hasauino/pusher_1290/renders/front.png

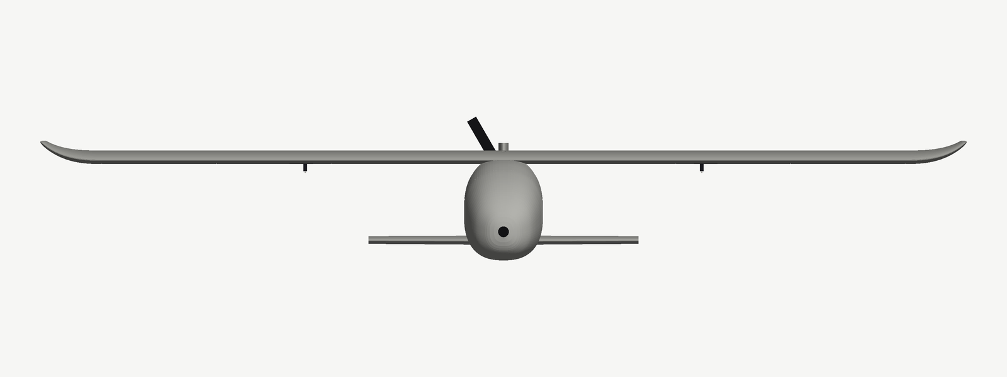
renders/front.png
