hasauino/pusher_1290/renders/internals.png

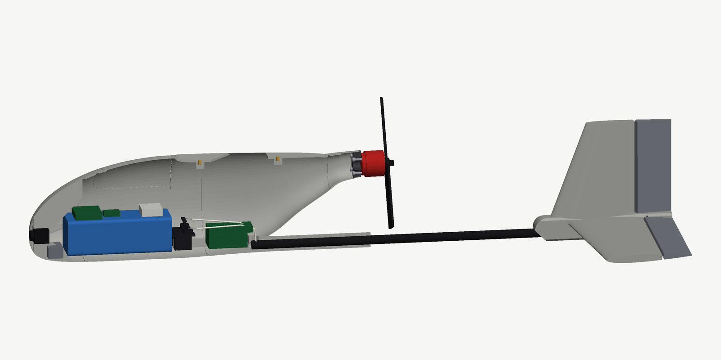
renders/internals.png
