hasauino/pusher_1290/renders/iso_rear.png

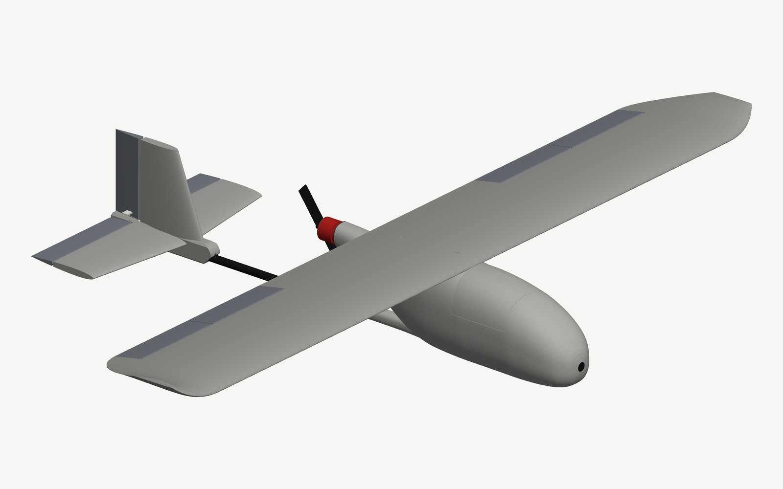
renders/iso_rear.png
