hasauino/pusher_1290/renders/side.png

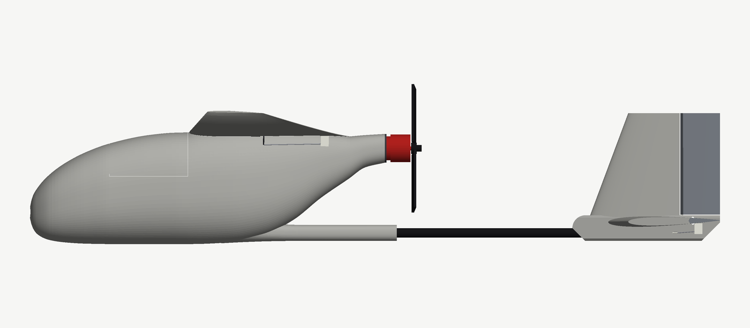
renders/side.png
