hasauino/pusher_1290/renders/top.png

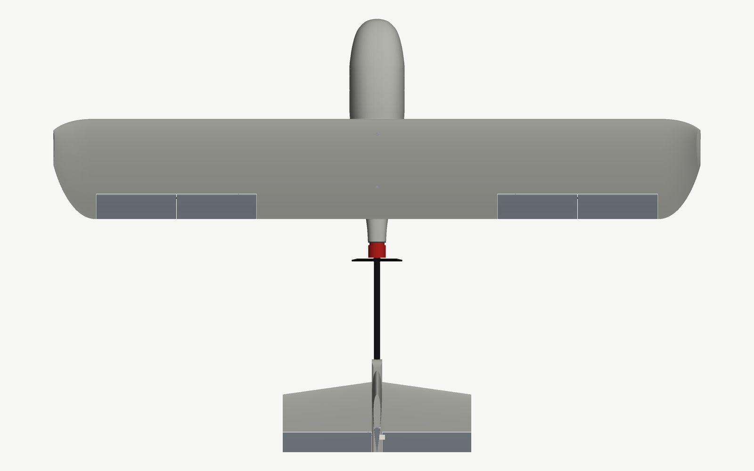
renders/top.png
