hasauino/pusher_1290/stl/PARTS.md

| File | Material | X x Y x Z on bed (mm) | Printed mass* (g) | Notes |
|---|---|---|---|---|
| 01_wing_center.stl | PLA | 142 x 142 x 160 | 52 | Bolts to the fuselage with 2x M3; carries both spars. |
| 02_wing_s1_R.stl | PLA | 142 x 142 x 160 | 50 | Plain panel. |
| 03_wing_s1_L.stl | PLA | 142 x 142 x 160 | 50 | Plain panel. |
| 04_wing_s2_R.stl | PLA | 110 x 109 x 160 | 58 | Aileron servo pocket (bottom). |
| 05_wing_s2_L.stl | PLA | 109 x 110 x 160 | 58 | Aileron servo pocket (bottom). |
| 06_wing_s3_R.stl | PLA | 110 x 109 x 160 | 43 | Outer aileron panel. |
| 07_wing_s3_L.stl | PLA | 109 x 110 x 160 | 43 | Outer aileron panel. |
| 08_wing_tip_R.stl | PLA | 143 x 144 x 85 | 26 | Upswept tip; print root down. |
| 09_wing_tip_L.stl | PLA | 144 x 143 x 85 | 26 | Upswept tip; print root down. |
| 10_aileron_inner_R.stl | PLA | 36 x 37 x 159 | 12 | Joined to the outer aileron by a 3 mm carbon rod. |
| 11_aileron_inner_L.stl | PLA | 37 x 36 x 159 | 12 | Joined to the outer aileron by a 3 mm carbon rod. |
| 12_aileron_outer_R.stl | PLA | 36 x 37 x 159 | 12 |  |
| 13_aileron_outer_L.stl | PLA | 37 x 36 x 159 | 12 |  |
| 14_fuse_1_nose.stl | PLA | 121 x 108 x 85 | 41 | Camera nose; slides over the front segment's sleeve (screw or tape it). |
| 15_fuse_2_front.stl | PLA | 136 x 136 x 175 | 98 | Battery bay; hatch on top. |
| 16_fuse_3_rear.stl | PLA | 131 x 131 x 175 | 109 | Wing saddle rear, boom socket start, motor cone start. |
| 17_fuse_4_tail_motor_cone.stl | PETG | 50 x 50 x 40 | 7 | Print in PETG/PLA: carries the motor. |
| 18_fuse_4_tail_boom_socket.stl | PLA | 20 x 21 x 45 | 13 | Boom tail of the socket; the boom aligns it. |
| 19_fuse_hatch.stl | PLA | 95 x 95 x 104 | 19 | Battery hatch: front tab hooks under the skin; tape or a magnet at the back. |
| 20_motor_mount.stl | PETG | 37 x 36 x 10 | 11 | Check the hole pattern against your motor before printing. |
| 21_tail_fin_hub.stl | PLA | 145 x 145 x 160 | 41 | Boom socket, fin, stab mounts, elevator + rudder servo pockets. |
| 22_tail_rudder.stl | PLA | 37 x 37 x 127 | 10 |  |
| 23_tail_stab_R.stl | PLA | 74 x 74 x 178 | 28 | Root face down. |
| 24_tail_stab_L.stl | PLA | 74 x 74 x 178 | 28 | Root face down. |
| 25_tail_elevator_R.stl | PLA | 29 x 29 x 177 | 10 | Halves joined by a 2 mm wire. |
| 26_tail_elevator_L.stl | PLA | 29 x 29 x 177 | 10 | Halves joined by a 2 mm wire. |

*Estimate in PLA (PETG where marked) with the README print settings: wing panels and fuselage shells are modelled at their true wall thickness; solid parts (tips, tail, ailerons) print with one wall and 5 % infill.
