hasauino/pusher_1290/renders/parts_sheet.png

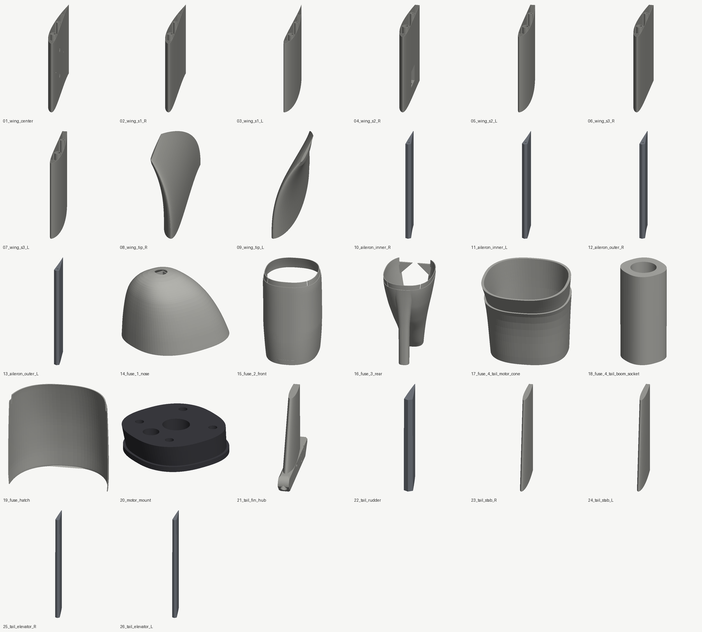
renders/parts_sheet.png
