hasauino/pusher_1290/assembly/pusher_1290_full.3mf

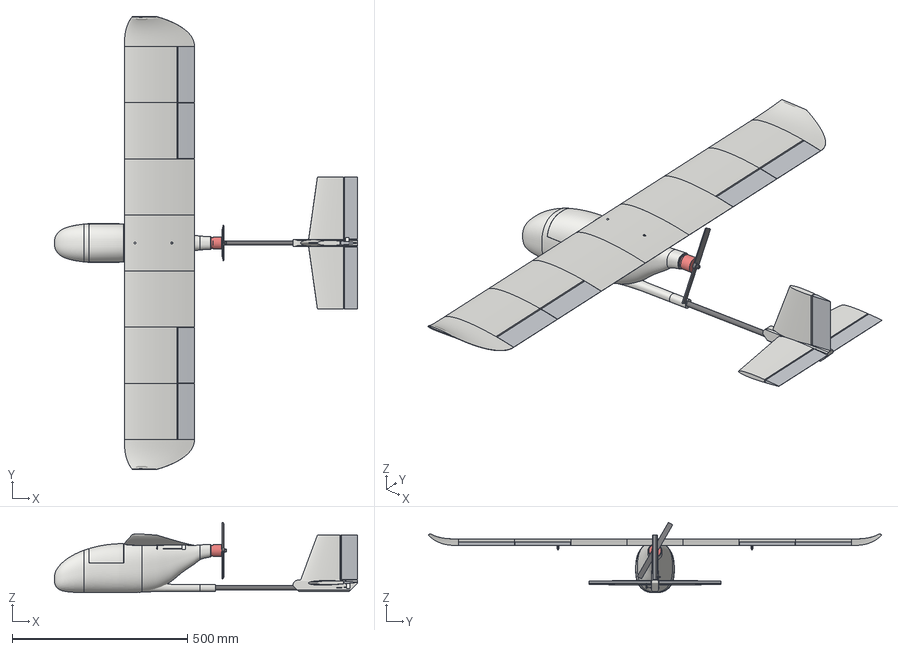
[picture p11: CAD file, 2026-10-11]
assembly/pusher_1290_full.3mf
864.7 x 1290.9 x 200.7 mm
wing_center
wing_s1_R
wing_s1_L
wing_s2_R
wing_s2_L
wing_s3_R
wing_s3_L
wing_tip_R
wing_tip_L
aileron_inner_R
aileron_inner_L
aileron_outer_R
aileron_outer_L
fuse_1_nose
fuse_2_front
fuse_3_rear
fuse_4_tail_motor_cone
fuse_4_tail_boom_socket
fuse_hatch
motor_mount
tail_fin_hub
tail_rudder
tail_stab_R
tail_stab_L
tail_elevator_R
tail_elevator_L
Main spar
Rear spar R
Rear spar L
Aileron joiner R
Aileron joiner L
Boom
Stab spar
Stab pin
Elevator joiner
Wing bolt front
Heat-set insert front
Wing bolt rear
Heat-set insert rear
Motor screw -9.5/-9.5
Motor screw -9.5/+9.5
Motor screw +9.5/-9.5
Motor screw +9.5/+9.5
Aileron servo R
Aileron servo L
Elevator servo
Rudder servo
Elevator Bowden cable
Elevator pushrod ends
Elevator horn
Rudder Bowden cable
Rudder pushrod ends
Rudder horn
Aileron horn R
Aileron pushrod R
Aileron horn L
Aileron pushrod L
Motor
Propeller
Battery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
