hasauino/pusher_1290/stl/16_fuse_3_rear.stl

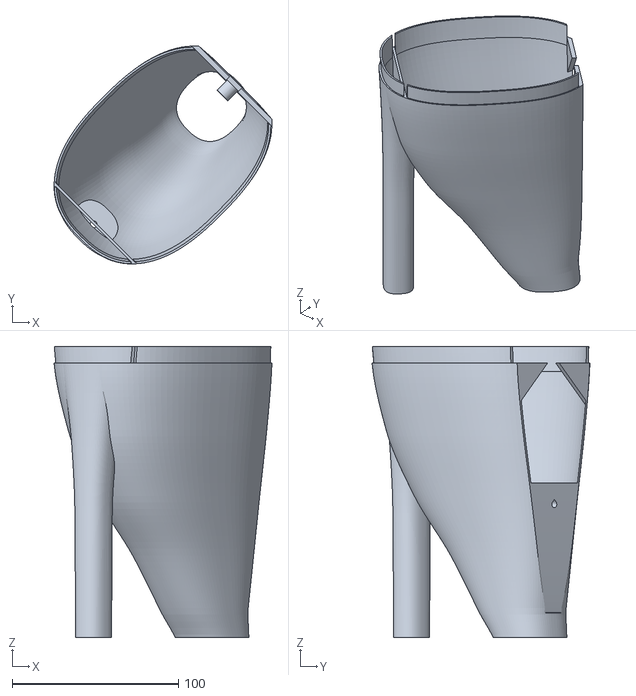
[picture p12: CAD file, 2026-10-11]
stl/16_fuse_3_rear.stl
131.0 x 131.0 x 175.0
