hasauino/pusher_1290/assembly/pusher_1290.stl

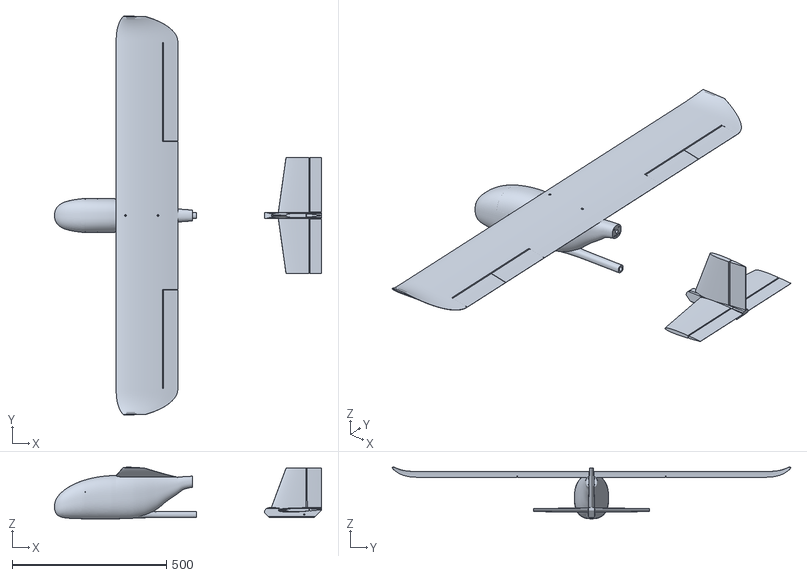
[picture p13: CAD file, 2026-10-11]
assembly/pusher_1290.stl
864.7 x 1290.9 x 167.1
