hasauino/pusher_1290/stl/21_tail_fin_hub.stl

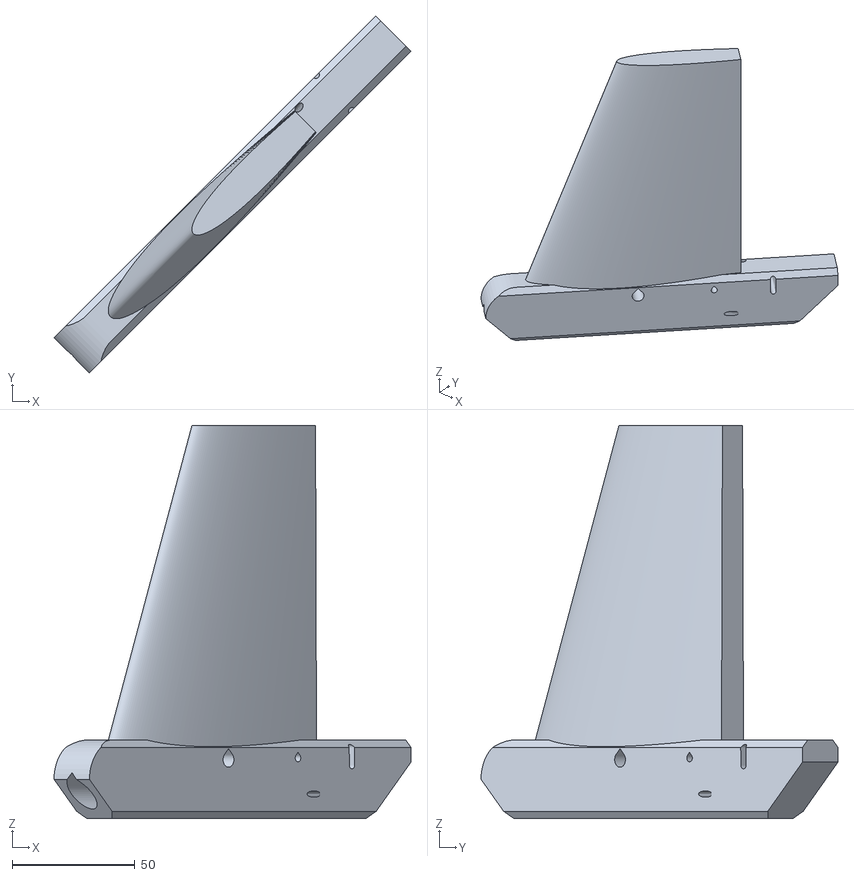
[picture p14: CAD file, 2026-10-11]
stl/21_tail_fin_hub.stl
145.2 x 145.2 x 160.0
