hasauino/pusher_1290/stl/07_wing_s3_L.stl

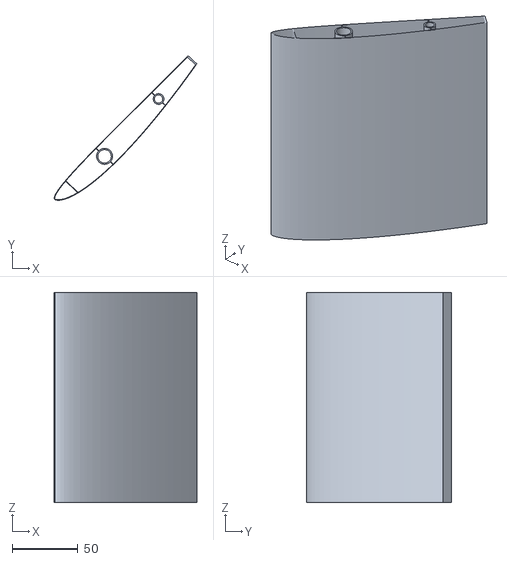
[picture p15: CAD file, 2026-10-11]
stl/07_wing_s3_L.stl
108.8 x 110.2 x 160.0
