hasauino/pusher_1290/stl/02_wing_s1_R.stl

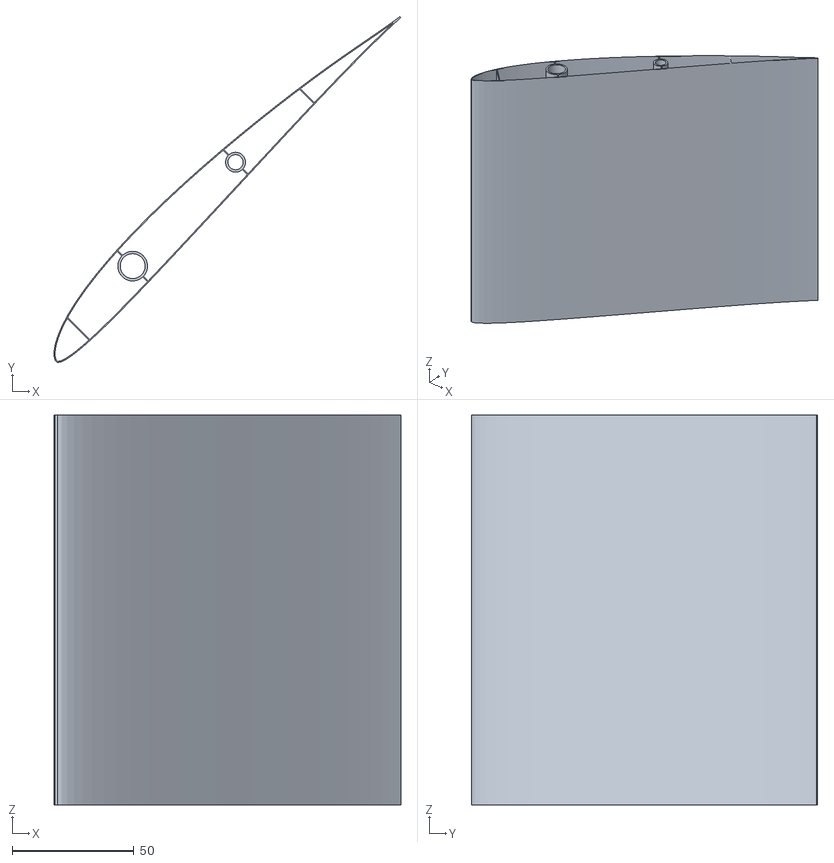
[picture p16: CAD file, 2026-10-11]
stl/02_wing_s1_R.stl
142.4 x 142.0 x 160.0
