hasauino/pusher_1290/stl/14_fuse_1_nose.stl

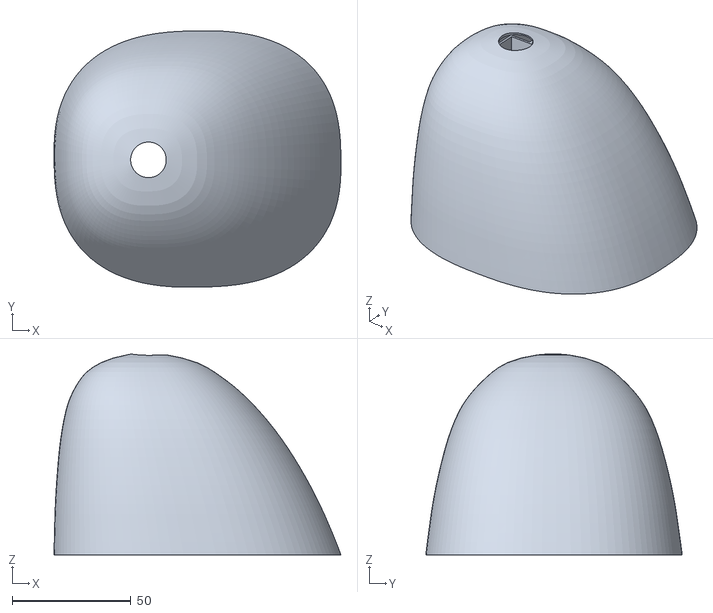
[picture p17: CAD file, 2026-10-11]
stl/14_fuse_1_nose.stl
120.9 x 108.0 x 84.7
