hasauino/pusher_1290/stl/19_fuse_hatch.stl

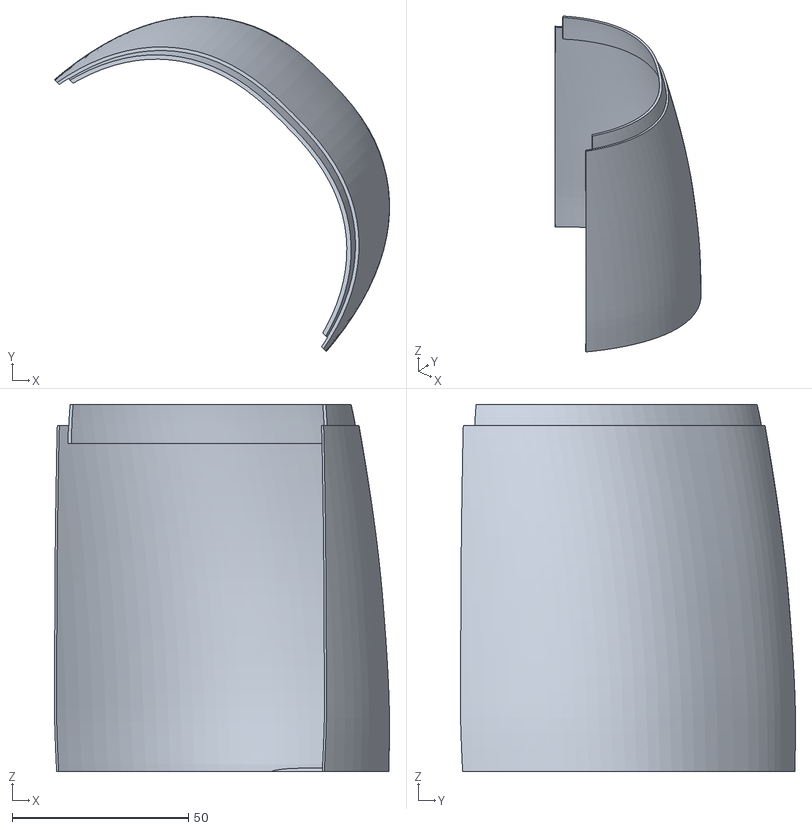
[picture p18: CAD file, 2026-10-11]
stl/19_fuse_hatch.stl
94.9 x 94.9 x 104.0
