hasauino/pusher_1290/stl/20_motor_mount.stl

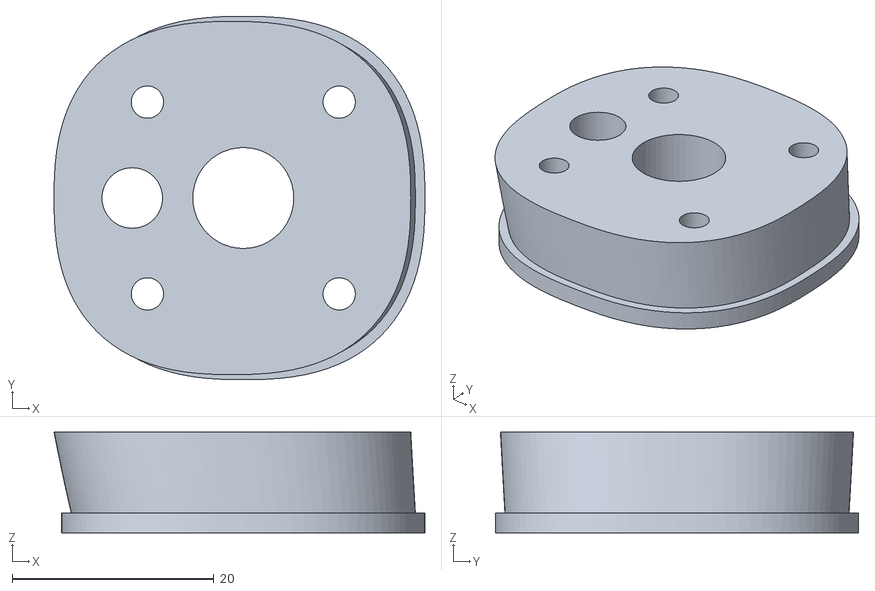
[picture p19: CAD file, 2026-10-11]
stl/20_motor_mount.stl
36.8 x 36.0 x 10.0
