hasauino/pusher_1290/stl/17_fuse_4_tail_motor_cone.stl

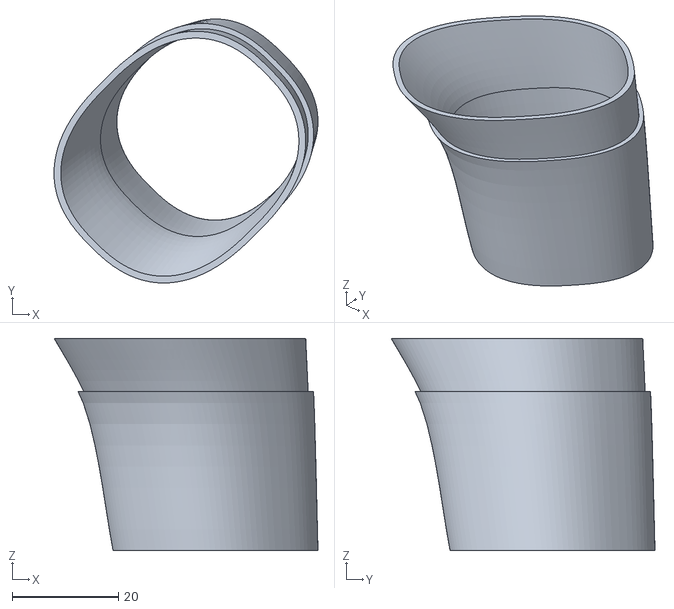
[picture p20: CAD file, 2026-10-11]
stl/17_fuse_4_tail_motor_cone.stl
49.7 x 49.7 x 40.0
