hasauino/pusher_1290/stl/15_fuse_2_front.stl

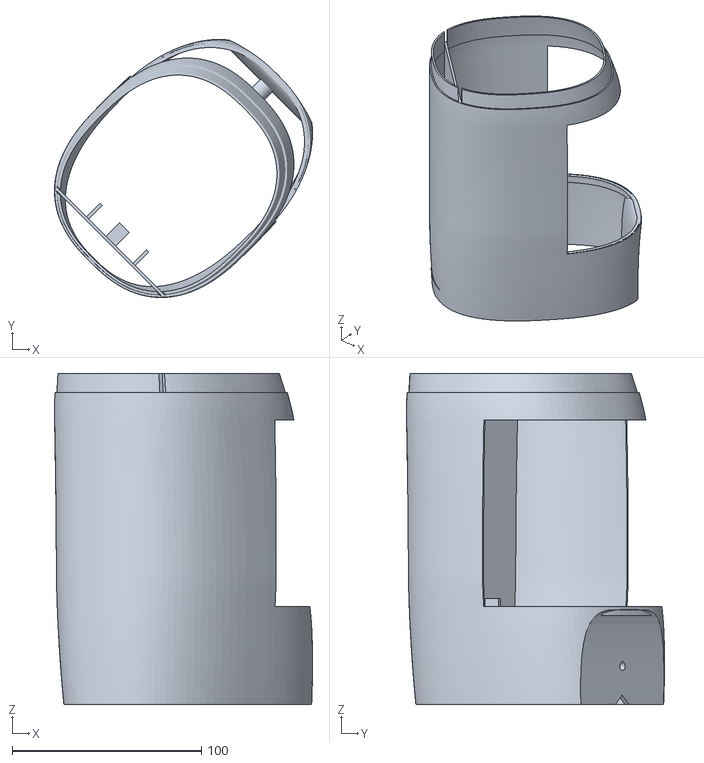
[picture p21: CAD file, 2026-10-11]
stl/15_fuse_2_front.stl
136.5 x 136.5 x 175.0
