hasauino/pusher_1290/stl/08_wing_tip_R.stl

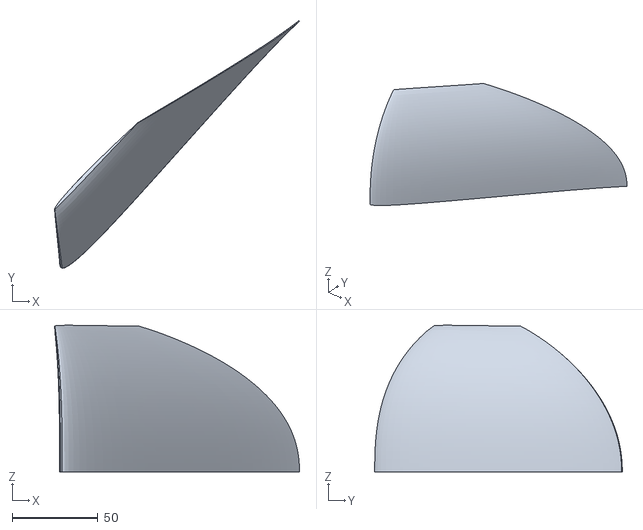
[picture p22: CAD file, 2026-10-11]
stl/08_wing_tip_R.stl
142.9 x 144.4 x 85.5
