hasauino/pusher_1290/stl/12_aileron_outer_R.stl

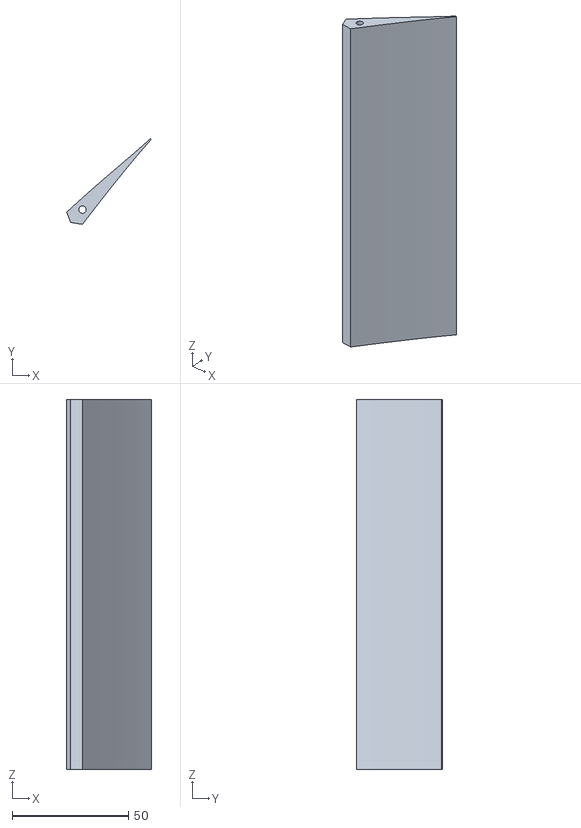
[picture p23: CAD file, 2026-10-11]
stl/12_aileron_outer_R.stl
36.4 x 36.8 x 159.0
