hasauino/pusher_1290/stl/24_tail_stab_L.stl

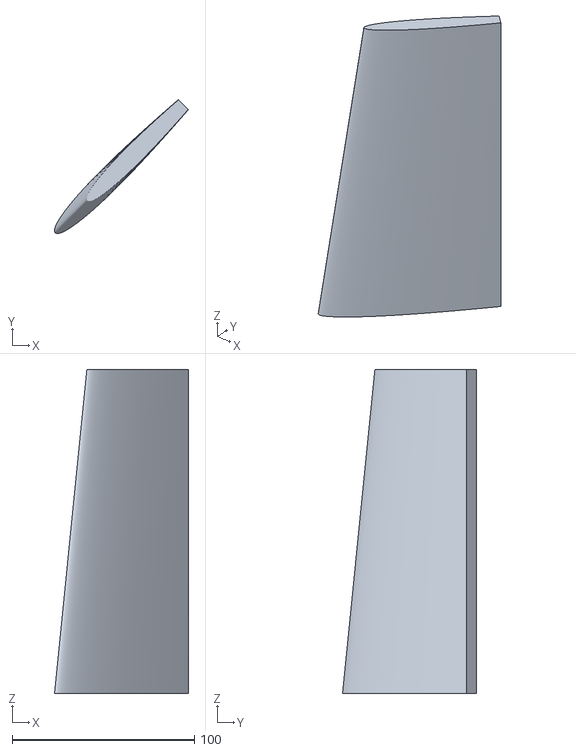
[picture p24: CAD file, 2026-10-11]
stl/24_tail_stab_L.stl
73.5 x 73.5 x 177.8
