hasauino/pusher_1290/stl/18_fuse_4_tail_boom_socket.stl

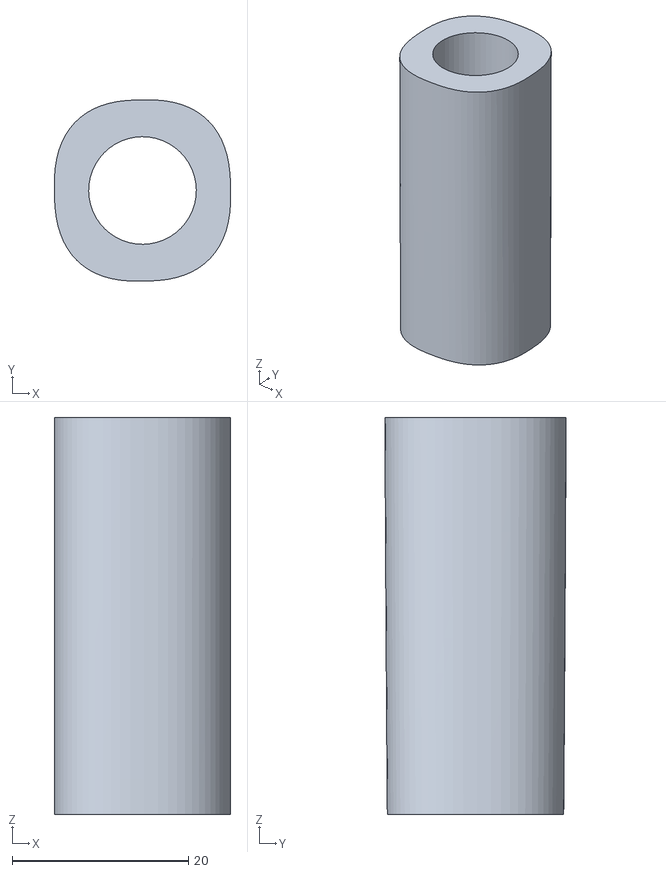
[picture p25: CAD file, 2026-10-11]
stl/18_fuse_4_tail_boom_socket.stl
20.0 x 20.6 x 45.0
