hasauino/pusher_1290/stl/22_tail_rudder.stl

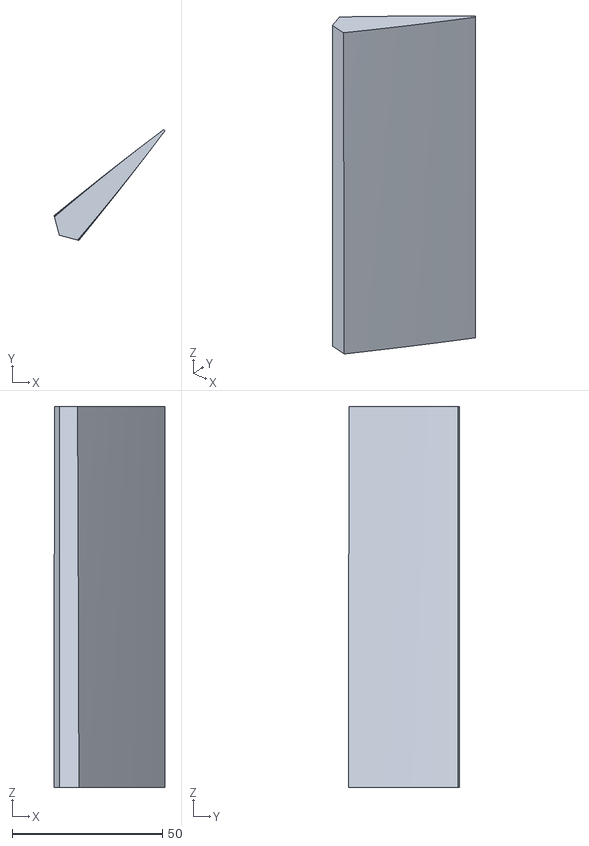
[picture p26: CAD file, 2026-10-11]
stl/22_tail_rudder.stl
37.0 x 37.0 x 127.0
