hasauino/pusher_1290/stl/25_tail_elevator_R.stl

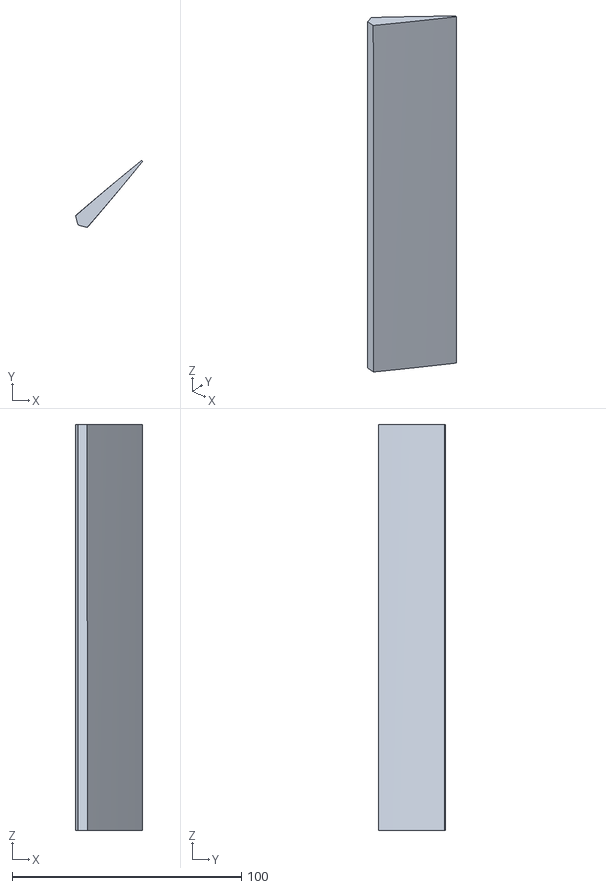
[picture p27: CAD file, 2026-10-11]
stl/25_tail_elevator_R.stl
29.2 x 29.2 x 177.0
