hasauino/pusher_1290/(list of files, cad)

Other CAD files:
stl/06_wing_s3_R.stl
stl/01_wing_center.stl
stl/04_wing_s2_R.stl
stl/03_wing_s1_L.stl
stl/05_wing_s2_L.stl
stl/09_wing_tip_L.stl
stl/13_aileron_outer_L.stl
stl/11_aileron_inner_L.stl
stl/23_tail_stab_R.stl
stl/26_tail_elevator_L.stl
assembly/pusher_1290_full.stl
