hasauino/pusher_1290/manual/index.html

Build manual · Bambu Lab A1 mini · 180 × 180 × 180 mm

# Pusher 1290

A 1290 mm pusher FPV airframe with a pod fuselage, carbon tail boom and SD7037 wing, split into 26 parts that each fit the A1 mini's plate. Drag to orbit the model, scroll to zoom, and hover a part to see its file name.

Loading 3D model…

Assembled Exploded

Drag to orbit · scroll to zoom

Wingspan

1290 mm

Length

865 mm

Wing

SD7037 200 mm chord

Printed parts

26 ~879 g PLA

All-up weight

1.84 kg, 4S 5200 mAh

Best glide

15.3 L/D at 54 km/h

Parts

## Every part, as it sits on the plate

The STL files come already oriented and centred for the A1 mini. Pick a part to see it on the 180 mm plate in its print orientation. No part needs supports.

### Wing

wing_center160 mm wing_s1_R160 mm wing_s1_L160 mm wing_s2_R160 mm wing_s2_L160 mm wing_s3_R160 mm wing_s3_L160 mm wing_tip_R86 mm wing_tip_L86 mm aileron_inner_R159 mm aileron_inner_L159 mm aileron_outer_R159 mm aileron_outer_L159 mm

### Fuselage

fuse_1_nose85 mm fuse_2_front175 mm fuse_3_rear175 mm fuse_4_tail_motor_cone40 mm fuse_4_tail_boom_socket45 mm fuse_hatch104 mm motor_mount10 mm

### Tail

tail_fin_hub160 mm tail_rudder127 mm tail_stab_R178 mm tail_stab_L178 mm tail_elevator_R177 mm tail_elevator_L177 mm

Loading 3D model…

File

—

Material

—

Size on plate

—

Est. weight

—

Note

—

Bill of materials

## What to print and what to buy

Print one of each file; left and right parts are separate, mirrored files. Weights are estimates for the print settings below. Everything to buy is a common part you can order on Amazon, listed by the name to search for.

File | Material | Size on plate (mm) | PLA (g) | LW-PLA (g)
01_wing_center.stl | PLA | 142 × 142 × 160 | 52 | 23
02_wing_s1_R.stl | PLA | 142 × 142 × 160 | 50 | 22
03_wing_s1_L.stl | PLA | 142 × 142 × 160 | 50 | 22
04_wing_s2_R.stl | PLA | 110 × 109 × 160 | 58 | 26
05_wing_s2_L.stl | PLA | 109 × 110 × 160 | 58 | 26
06_wing_s3_R.stl | PLA | 110 × 109 × 160 | 43 | 19
07_wing_s3_L.stl | PLA | 109 × 110 × 160 | 43 | 19
08_wing_tip_R.stl | PLA | 143 × 144 × 86 | 26 | 12
09_wing_tip_L.stl | PLA | 144 × 143 × 86 | 26 | 12
10_aileron_inner_R.stl | PLA | 36 × 37 × 159 | 12 | 5
11_aileron_inner_L.stl | PLA | 37 × 36 × 159 | 12 | 5
12_aileron_outer_R.stl | PLA | 36 × 37 × 159 | 12 | 5
13_aileron_outer_L.stl | PLA | 37 × 36 × 159 | 12 | 5
14_fuse_1_nose.stl | PLA | 121 × 108 × 85 | 41 | 18
15_fuse_2_front.stl | PLA | 136 × 136 × 175 | 98 | 43
16_fuse_3_rear.stl | PLA | 131 × 131 × 175 | 109 | 48
17_fuse_4_tail_motor_cone.stl | PETG | 50 × 50 × 40 | 7 | 7
18_fuse_4_tail_boom_socket.stl | PLA | 20 × 21 × 45 | 13 | 6
19_fuse_hatch.stl | PLA | 95 × 95 × 104 | 19 | 8
20_motor_mount.stl | PETG | 37 × 36 × 10 | 11 | 11
21_tail_fin_hub.stl | PLA | 145 × 145 × 160 | 41 | 18
22_tail_rudder.stl | PLA | 37 × 37 × 127 | 10 | 4
23_tail_stab_R.stl | PLA | 74 × 74 × 178 | 28 | 13
24_tail_stab_L.stl | PLA | 74 × 74 × 178 | 28 | 13
25_tail_elevator_R.stl | PLA | 29 × 29 × 177 | 10 | 4
26_tail_elevator_L.stl | PLA | 29 × 29 × 177 | 10 | 4
26 parts | | | 879 | 398

Carbon and hardware | Quantity
Carbon tube 10 × 8 mm (main spar) | 1 × 1000 mm
Carbon tube 6 × 4 mm (rear spars, stab spar) | 2 × 590 mm, 1 × 130 mm
Carbon tube 12 × 10 mm (boom) | 1 × 490 mm
Carbon rod 3 mm (stab pin, aileron joiners) | 3 × 80 mm
Piano wire 2 mm (elevator joiner) | 1 × 100 mm
Bowden cable: 2 mm tube with 1 mm steel pushrod (elevator, rudder) | 2 × ~700 mm
Steel pushrod 1.2 mm with clevis (ailerons) | 2
Nylon control horns | 4
CA hinges | ~14
M3 brass heat-set inserts (5.7 mm) | 2
M3 socket head screws | 1 × 20 mm, 5 × 14 mm (wing rear, motor)
Adhesive lead wheel weights (nose weight) | ~92 g
Magnet 6 × 3 mm (hatch) | 1

Electronics | Search for
Motor | EMAX ECO II 2807 1300KV (19 × 19 mm M3 mount)
Propeller | 7 inch FPV prop, reverse rotation (e.g. 7040)
ESC | Hobbywing Skywalker V2 40A (5 A BEC)
Servos | 4 × MG90S metal-gear 9 g micro servo
Flight controller | SpeedyBee F405 WING APP
GPS | Beitian BN-880 (with compass)
Receiver | RadioMaster RP1 ELRS 2.4 GHz
Camera and VTX | Caddx Ratel 2 (19 mm) and a 5.8 GHz VTX (30.5 mm mounting)
Battery | 4S 5200 mAh LiPo, XT60, at most 140 × 48 × 48 mm

The motor mount takes the standard 19 × 19 mm M3 pattern of 2806/2807 motors, with a 10 mm centre hole. If you buy a different motor, check its pattern before printing 20_motor_mount.stl.

Printing

## Slicer settings

Bambu Studio, 0.4 mm nozzle, 0.2 mm layers. Load the STLs as they are: their orientation is part of the design.

Parts | Wall loops | Infill | Top / bottom | Why
Wing centre, S1, S2, S3 | 1 | 0 % | 3 | 0.45 mm skin and internal walls are modelled in; set the wall line width to 0.45 mm.
Wing tips, ailerons, stabiliser, elevators, rudder, fin hub | 1 | 5 % gyroid | 3 | Solid parts. Add a 5 mm brim to the tall thin ones.
Fuselage segments, hatch | 2 | 10 % gyroid | 3 | 0.8 mm shell. Infill only fills the boom-socket walls.
Motor mount, motor cone | 4 | 40 % | 4 | Print in PETG: they carry the motor and run warm.

### Designed for PLA

The walls are sized for regular PLA: about 879 g of printed parts. Foamed PLA (LW-PLA, Bambu PLA Aero) also works and weighs about 398 g, but then the plane is nose-heavy: leave out the nose weight and move the battery about 30 mm back.

### Before you print

- Use a brim on 16_fuse_3_rear: it stands on a thin ring next to the boom-socket column.
- Turn on thick bridges if your printer bridges poorly. The servo-pocket ceilings in S2 and the ring around the camera hole are short bridges.
- PLA softens around 55 °C. Don't leave the plane in a hot car.

Assembly

## Six steps from parts to plane

Watch the whole build, or select a step below to highlight its parts. Medium CA or 5-minute epoxy works for every glue joint.

The whole build, seen from the workbench. The video builds the fuselage first and fits the wing last; the six steps below join the same parts in a different order, and either order works.

### Build the wing

1. Slide the 10 mm main spar and both 6 mm rear spars through the centre section, then S1, S2 and S3 on each side, gluing each joint. Glue the tips on; the rear spars end 35 mm inside them. Lay an MG90S servo flat in each pocket under S2, spline toward the trailing edge, and run its lead through the wing to the holes under the centre section.

### Fit the ailerons

2. Glue a 3 mm carbon rod through the inner and outer aileron on each side so they move as one. Hinge them along the point of the bevel, which allows ±30° of throw, then tape over the hinge gap. Glue a horn under each inner aileron and link it to the servo horn with a 1.2 mm Z-bend pushrod.

### Assemble the fuselage

3. Glue the front and rear segments and both tail-cone pieces together on their 10 mm sleeves. Melt the two M3 inserts into the bosses under the wing saddle. Glue the elevator and rudder servos upright between the floor rails, and the flight controller and ESC behind them. Bolt the motor to the mount, then glue the mount into the cone. Leave the nose unglued: the battery slides in along the floor with the nose off.

### Fit the boom

4. Glue the 12 mm boom 160 mm into the fuselage socket and 110 mm into the tail hub. Square the fin to the wing before the glue sets. Then push the two Bowden cables from the tail servos through the boom: they come out of the hub beside the elevator and the rudder.

### Build the tail

5. Slide the stabiliser halves onto the 6 mm spar and 3 mm pin through the hub. Hinge the elevators and join them with the 2 mm wire through the hub slot, then hinge the rudder. Glue a horn under the left elevator and one on the right of the rudder, and Z-bend the Bowden pushrods into them.

### Mount the wing and balance

6. Seat the wing in the saddle with the M3 × 20 bolt at the front and the M3 × 14 at the back. Slide the battery in, fit the nose and the hatch, then balance the plane at 66 mm behind the wing's leading edge. With PLA parts and a 4S 5200 mAh LiPo that takes about 92 g of lead in the nose, below the camera: add or remove weight until it balances.

Loading 3D model…

Flight setup

## Balance, throws and speeds

Figures come from the aerodynamic model at 1.84 kg. The design is not flight-tested, so range-check it, verify the balance and do a few gentle hand-launched glides before the first powered flight.

Balance point, behind the wing's leading edge66 mmSafe range 57–77 mm

Best glide (range)15 m/s54 km/h, L/D 15.3

Longest flight time12 m/s43 km/h, about 32 W

Slowest level flight9.3 m/s33 km/h at 1.84 kg

Control | First-flight throw | Servo
Ailerons | ±12° | One per side, in S2
Elevator | ±10° | In the pod, Bowden cable through the boom
Rudder | ±15° | In the pod, Bowden cable through the boom

Pusher 1290 is an original parametric design. Its layout is inspired by the Flightory Lark, but it shares no geometry with it and is not affiliated with Flightory.

Generated from the project's CAD source: every number on this page and every 3D view come from the same parameters as the STL files.
