hasauino/pusher_1290/manual/assembly-poster.jpg

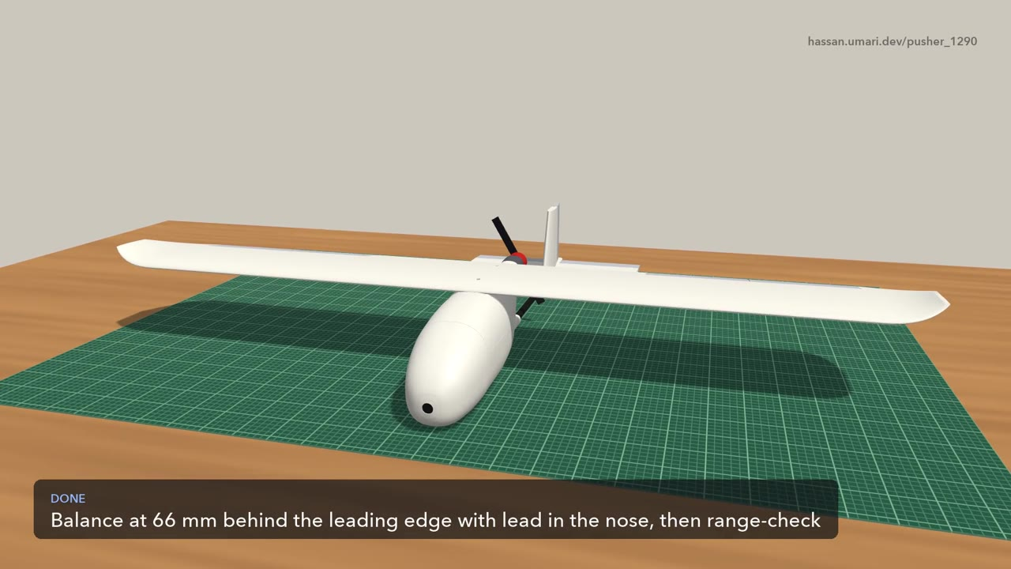
manual/assembly-poster.jpg
