hasauino/pusher_1290/(commit log)

2026-10-11 Pusher 1290: 3D-printable 1290 mm pusher RC plane for the A1 mini
    Parametric CAD (Python + manifold3d) for a pod-and-boom pusher airframe
    split into 26 parts that each fit a 180 mm print bed, with print-ready
    STLs, an assembly model, an aerodynamic analysis (AeroSandbox) and an
    interactive three.js build manual.
    [01_wing_center.stl, 02_wing_s1_R.stl, 03_wing_s1_L.stl, 04_wing_s2_R.stl, 05_wing_s2_L.stl, 06_wing_s3_R.stl, 07_wing_s3_L.stl, 08_wing_tip_R.stl]
2026-10-11 Publish the build manual to GitHub Pages
    A workflow rebuilds the manual from the CAD on every push to main and
    deploys it with GitHub Pages. export_web.py gains --site, which writes a
    standalone page (full HTML document) plus its model data.
2026-10-11 Update assembly instructions and render assets
    - Adjusted dimensions for rear spar and wing bolts in the assembly instructions.
    - Updated battery configuration to specify two 4S3P 18650 packs.
    - Added data-group attributes to various assembly steps for better organization.
    - Modified the build assembly function to incorporate group data for parts.
    - Updated rendering assets: modified existing images and added new images for full assembly and internals.
    [pusher_1290.stl, pusher_1290_full.3mf, pusher_1290_full.stl]
2026-10-11 Use common Amazon parts, fix balance for a PLA build
    A full weight-and-balance check (new cad/mass.py) showed the plane was
    tail-heavy: the CG sat behind the neutral point, so it would not have
    flown. Fixed for a PLA build:
    - 9 g MG90S servos instead of EMAX ES08MA II; pockets resized
    - tail servos moved into the pod; Bowden cables run through the boom
    and exit the tail hub next to the horns (fin pockets removed)
    - thinner PLA walls (0.45 mm wing skin, 0.8 mm fuselage shell)
    - 4S 5200 mAh LiPo slides in through the nose, as far forward as it goes
    - ESC moved onto the flight controller; 92 g nose weight balances at 66 mm
    - motor mount changed to the 19 x 19 mm pattern of 2807 motors
    Every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
    [01_wing_center.stl, 02_wing_s1_R.stl, 03_wing_s1_L.stl, 04_wing_s2_R.stl, 05_wing_s2_L.stl, 06_wing_s3_R.stl, 07_wing_s3_L.stl, 14_fuse_1_nose.stl]
